ericka-assengue/ikounafy-smartbin-capacitive-sensor/docs/comsol-simulation-results.jpg

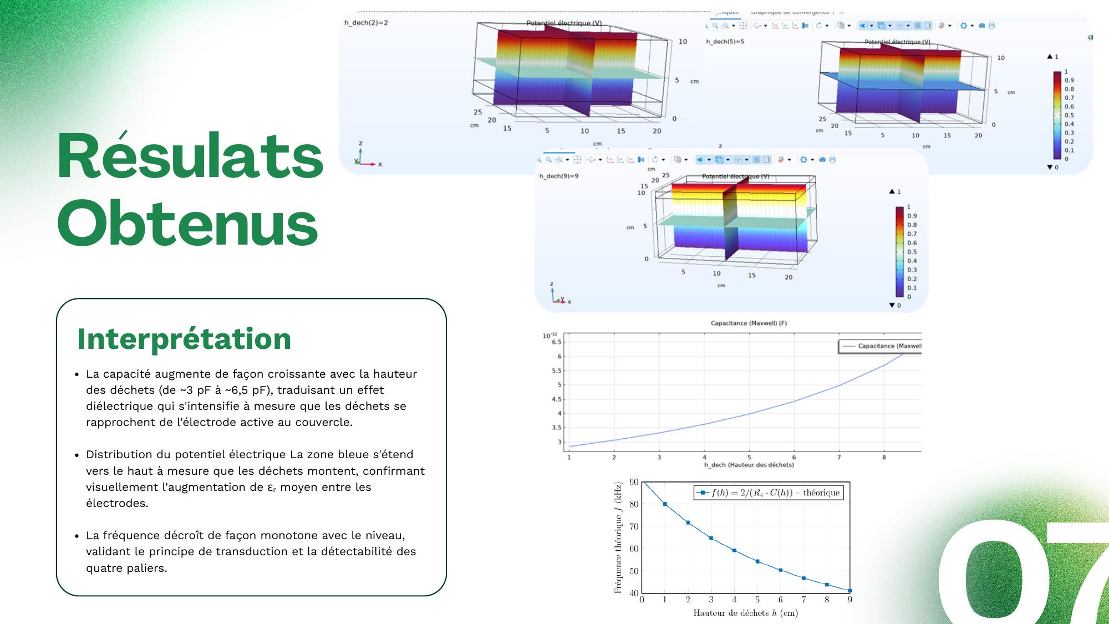
docs/comsol-simulation-results.jpg
