ericka-assengue/ikounafy-smartbin-capacitive-sensor/docs/solution-overview.jpg

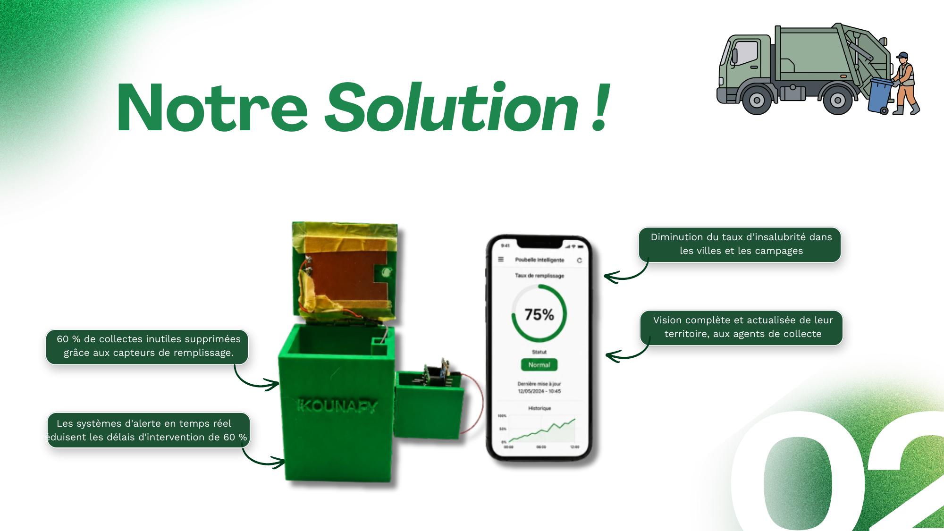
docs/solution-overview.jpg
