ericka-assengue/ikounafy-smartbin-capacitive-sensor/docs/conclusion-limits-perspectives.jpg

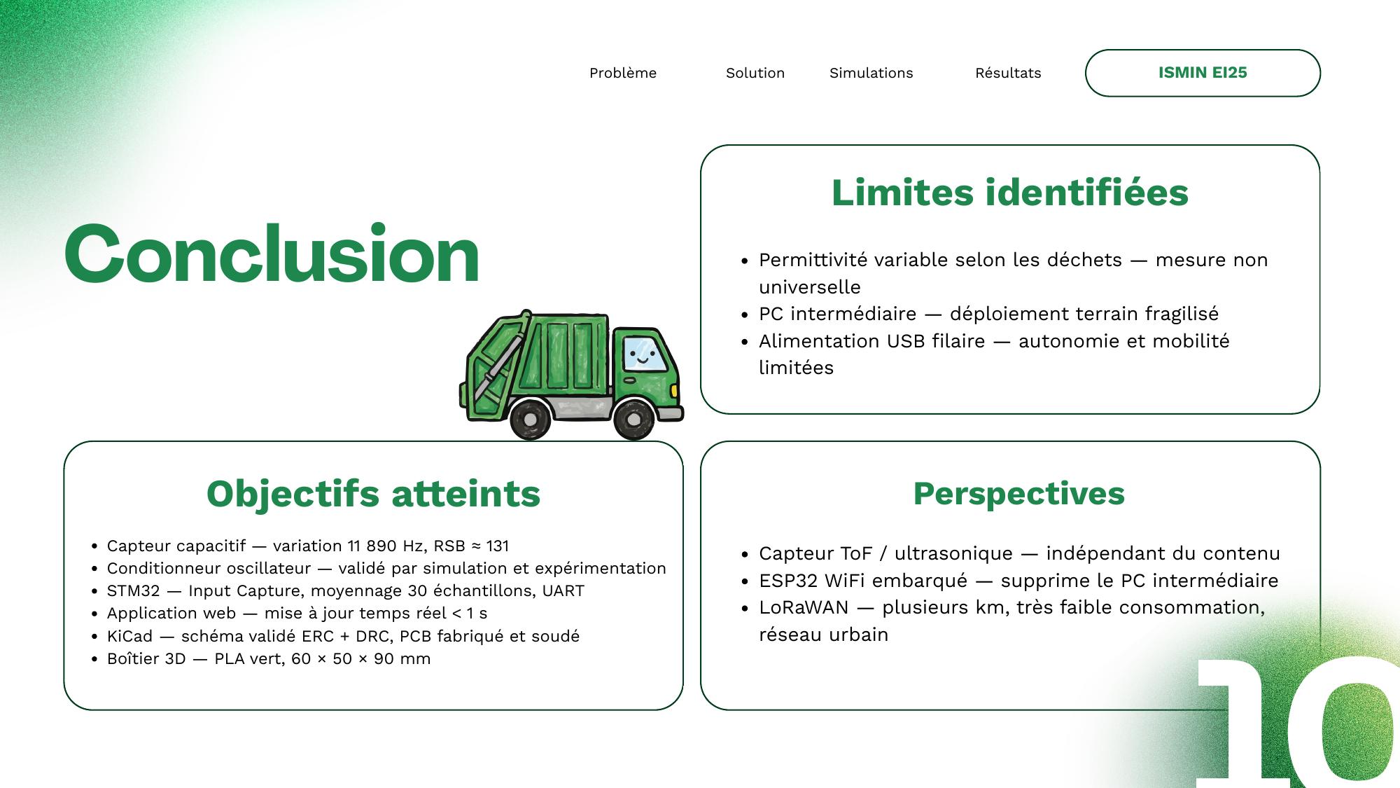
docs/conclusion-limits-perspectives.jpg
