ericka-assengue/ikounafy-smartbin-capacitive-sensor/docs/kicad-pcb-design.jpg

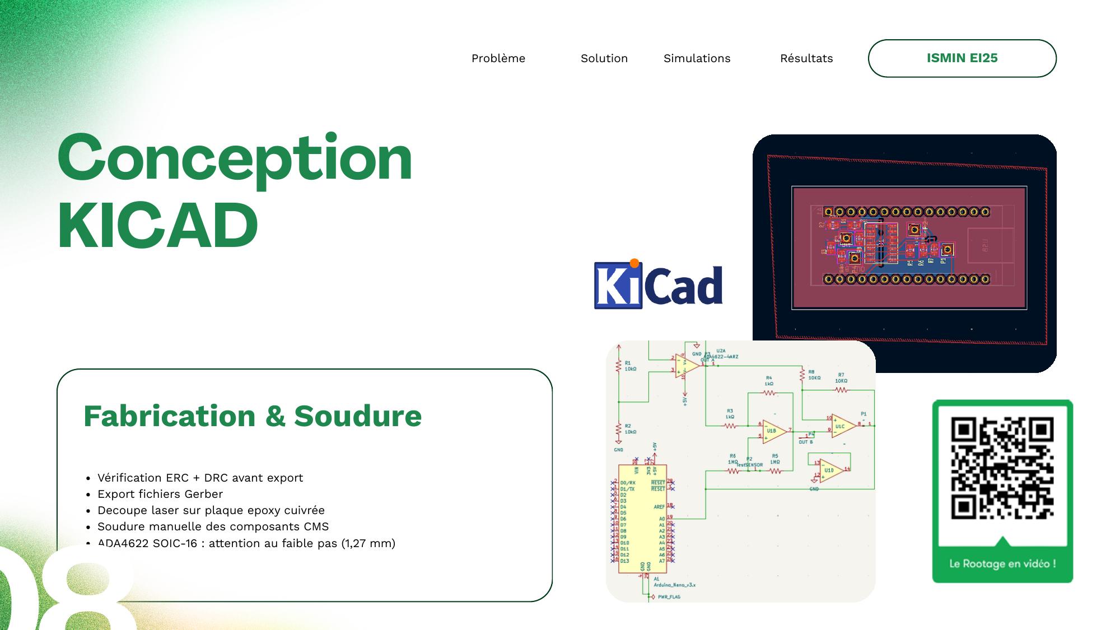
docs/kicad-pcb-design.jpg
