ericka-assengue/ikounafy-smartbin-capacitive-sensor/docs/oscillator-conditioning-circuit.jpg

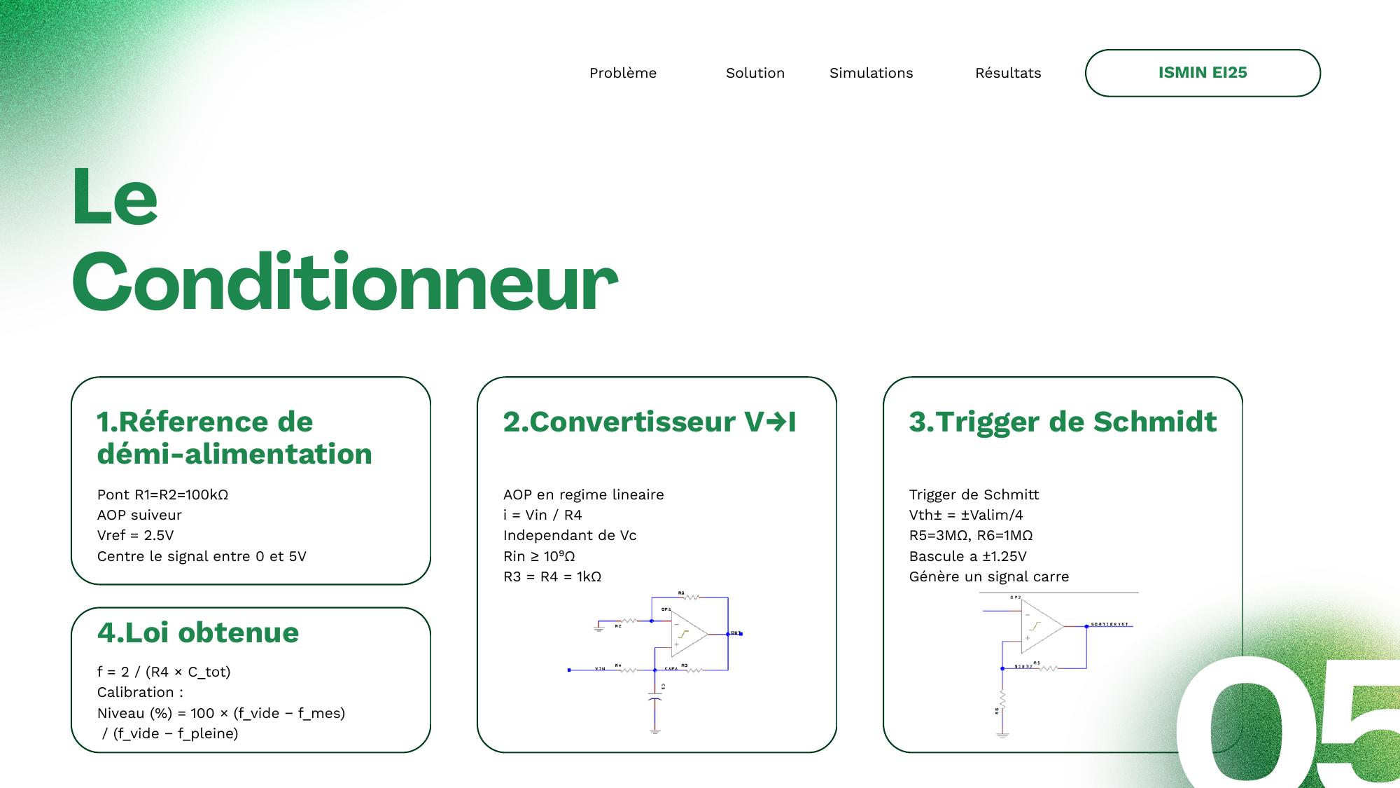
docs/oscillator-conditioning-circuit.jpg
