ericka-assengue/ikounafy-smartbin-capacitive-sensor/docs/physical-model-theory.jpg

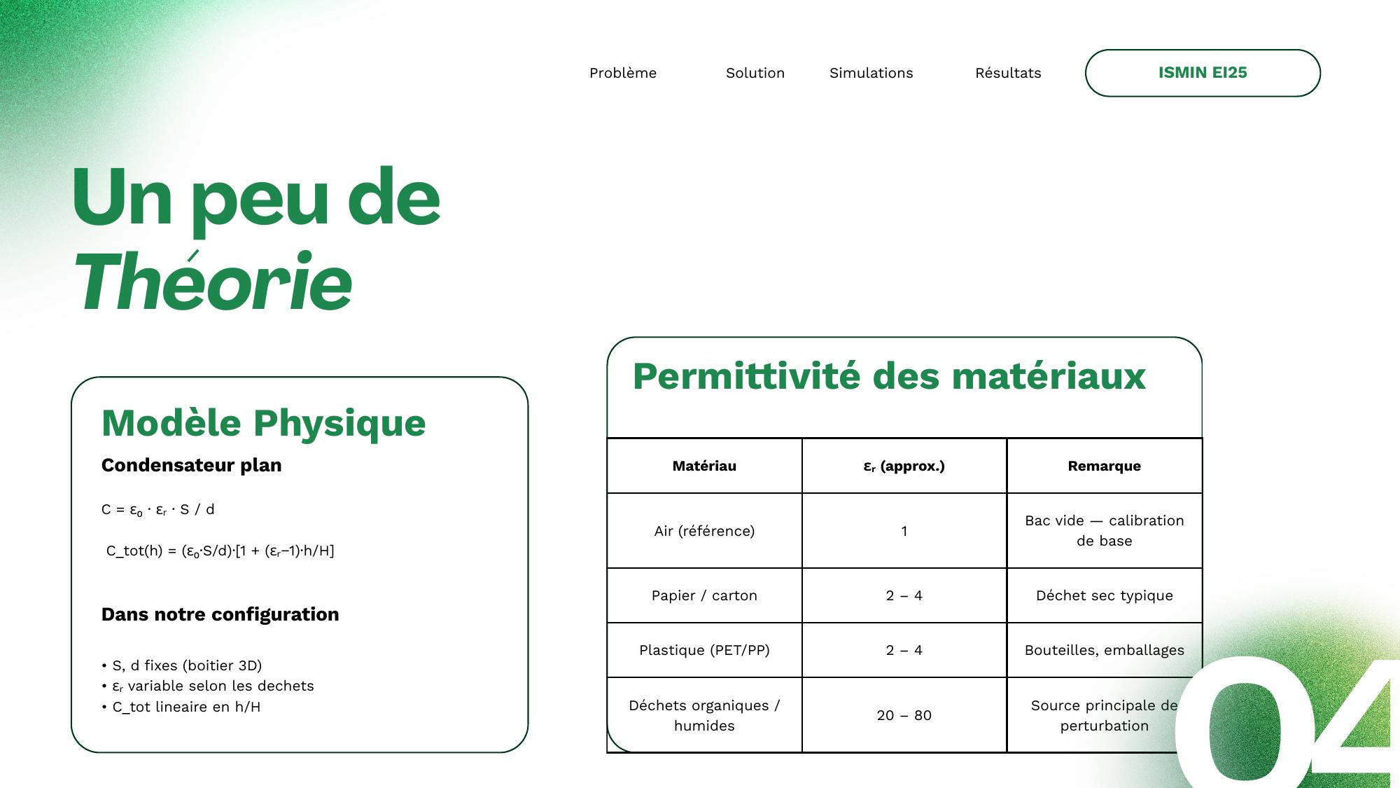
docs/physical-model-theory.jpg
