ericka-assengue/ikounafy-smartbin-capacitive-sensor/docs/stm32-pin-config.jpg

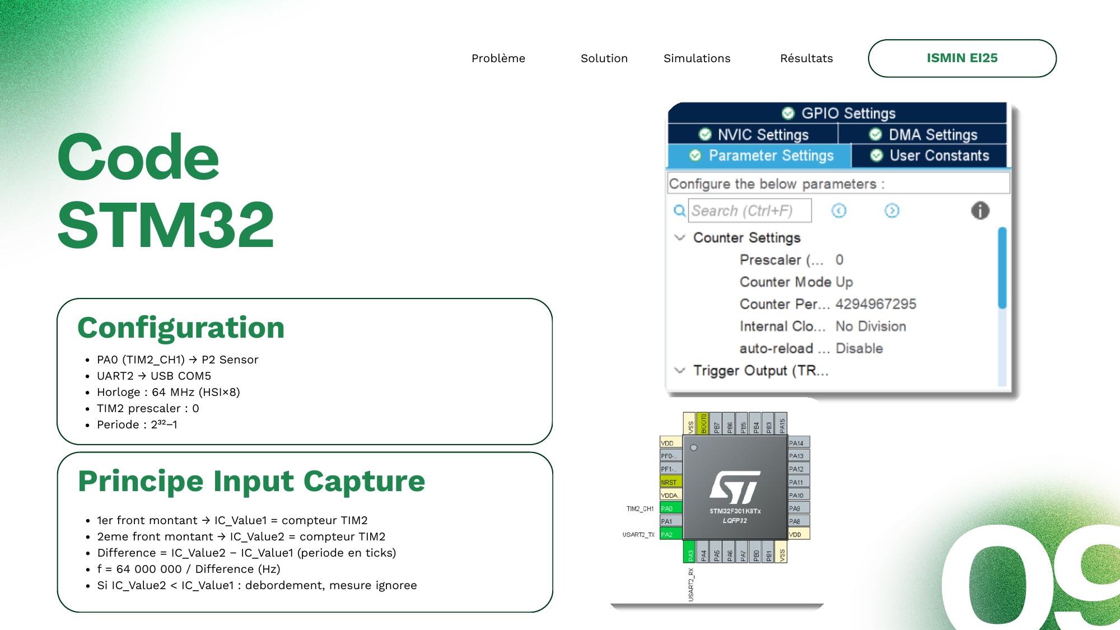
docs/stm32-pin-config.jpg
