ericka-assengue/ikounafy-smartbin-capacitive-sensor/docs/comsol-simulation-setup.jpg

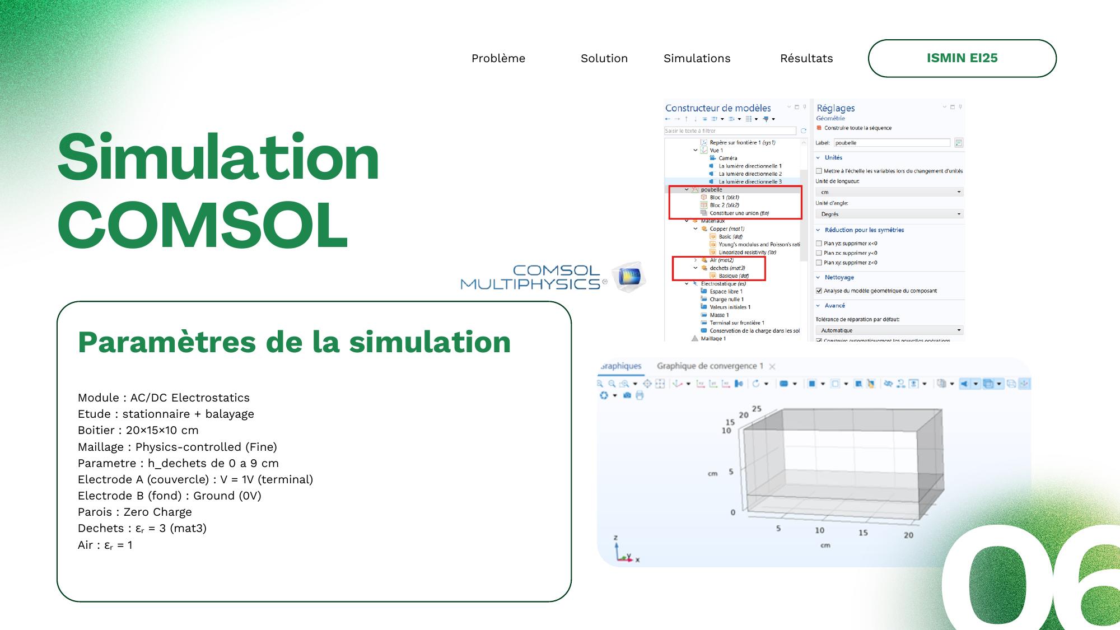
docs/comsol-simulation-setup.jpg
