ericka-assengue/ikounafy-smartbin-capacitive-sensor/docs/dashboard-and-results.jpg

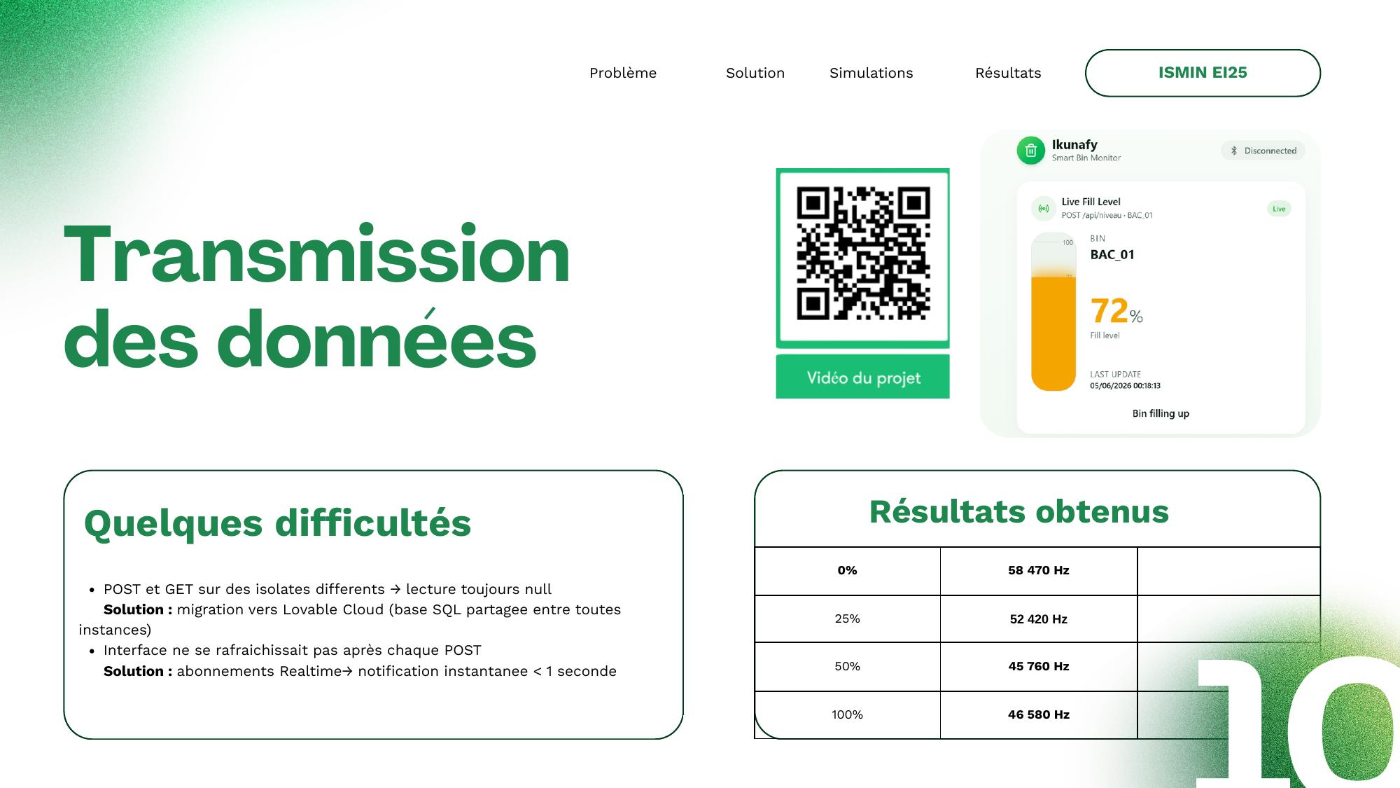
docs/dashboard-and-results.jpg
