ericka-assengue/ikounafy-smartbin-capacitive-sensor/Core/Src/main.c

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
/* Includes ------------------------------------------------------------------*/
#include "main.h"
#include <stdio.h>
#include <string.h>

/* USER CODE BEGIN PD */
#define BIN_EMPTY_FREQ_HZ   65500  // Calibrated oscillator frequency when the bin is empty
#define BIN_FULL_FREQ_HZ    43900  // Calibrated oscillator frequency when the bin is full
#define NUM_SAMPLES         30     // Number of measurements averaged per reading
/* USER CODE END PD */

TIM_HandleTypeDef htim2;

UART_HandleTypeDef huart2;

void SystemClock_Config(void);
static void MX_GPIO_Init(void);
static void MX_TIM2_Init(void);
static void MX_USART2_UART_Init(void);
/* USER CODE BEGIN 0 */

volatile int is_first_capture = 0;
volatile int ic_value_1 = 0;
volatile int ic_value_2 = 0;
volatile int capture_difference = 0;
volatile int measured_frequency = 0;
volatile int calculation_ready = 0;
char uart_tx_buffer[50];
int measurements[NUM_SAMPLES];
int measurement_index = 0;


/* USER CODE END 0 */

/**
  * @brief  The application entry point.
  * @retval int
  */
int main(void)
{

  /* MCU Configuration--------------------------------------------------------*/

  /* Reset of all peripherals, Initializes the Flash interface and the Systick. */
  HAL_Init();

  /* Configure the system clock */
  SystemClock_Config();

  /* Initialize all configured peripherals */
  MX_GPIO_Init();
  MX_TIM2_Init();
  MX_USART2_UART_Init();
  /* USER CODE BEGIN 2 */
  HAL_TIM_IC_Start_IT(&htim2, TIM_CHANNEL_1);
  /* USER CODE END 2 */

  /* Infinite loop */
  /* USER CODE BEGIN WHILE */

  while (1)
  {
      if (calculation_ready == 1)
      {
          measurements[measurement_index] = measured_frequency;
          measurement_index++;

          if (measurement_index >= NUM_SAMPLES)
          {
              int sum = 0;
              for (int i = 0; i < NUM_SAMPLES; i++)
                  sum += measurements[i];
              int average = sum / NUM_SAMPLES;

              int fill_level_percent;
              if (average >= BIN_EMPTY_FREQ_HZ)
                  fill_level_percent = 0;
              else if (average <= BIN_FULL_FREQ_HZ)
                  fill_level_percent = 100;
              else
                  fill_level_percent = (int)(100.0f *
                      (BIN_EMPTY_FREQ_HZ - average) /
                      (BIN_EMPTY_FREQ_HZ - BIN_FULL_FREQ_HZ));

              sprintf(uart_tx_buffer, "LEVEL:%d\r\n", fill_level_percent);
              HAL_UART_Transmit(&huart2,
                  (uint8_t*)uart_tx_buffer,
                  strlen(uart_tx_buffer), 200);
              measurement_index = 0;
          }
          calculation_ready = 0;
      }
      HAL_Delay(100);
  }
}

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
/* USER CODE BEGIN 4 */

void HAL_TIM_IC_CaptureCallback(TIM_HandleTypeDef *htim2)
{

	if (htim2->Channel == HAL_TIM_ACTIVE_CHANNEL_1)
	{
		if (is_first_capture == 0)
			{
				ic_value_1 = HAL_TIM_ReadCapturedValue(htim2, TIM_CHANNEL_1);
				is_first_capture = 1;
			}
		else if (is_first_capture)
		{
			ic_value_2 = HAL_TIM_ReadCapturedValue(htim2, TIM_CHANNEL_1);
			if (ic_value_2 > ic_value_1)
						{
				capture_difference = ic_value_2 - ic_value_1;
				measured_frequency = (float)HAL_RCC_GetHCLKFreq()/(float)capture_difference;

				calculation_ready = 1;
						}
			else calculation_ready = 0;
			is_first_capture = 0;
		}
	}
}
/* USER CODE END 4 */
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
