ericka-assengue/ikounafy-smartbin-capacitive-sensor/Ikounafy.ioc

Mcu.UserName=STM32F301K8Tx
PA0.Signal=S_TIM2_CH1_ETR
PA2.Signal=USART2_TX
PA3.Signal=USART2_RX
